Dutchfreak/EspZigbeePlantMonitor/3d Parts/Foot.stl

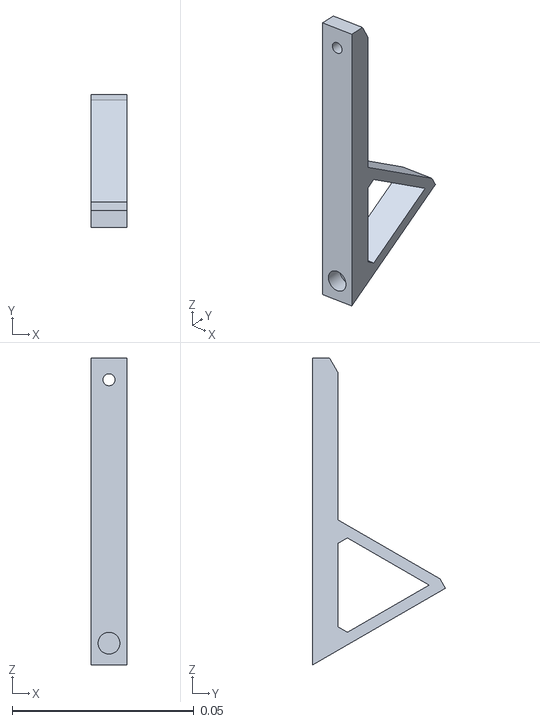
[picture p8: CAD file, 2026-10-31]
3d Parts/Foot.stl
0.01 x 0.0366 x 0.0845
