Dutchfreak/EspZigbeePlantMonitor/3d Parts/Backside.stl

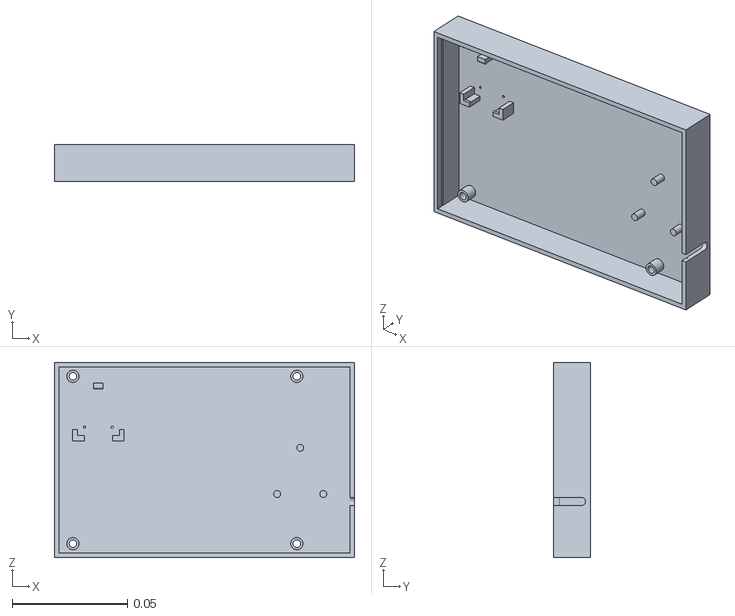
[picture p9: CAD file, 2026-10-31]
3d Parts/Backside.stl
0.13 x 0.016 x 0.0845
