Dutchfreak/EspZigbeePlantMonitor/3d Parts/FrontPlate.stl

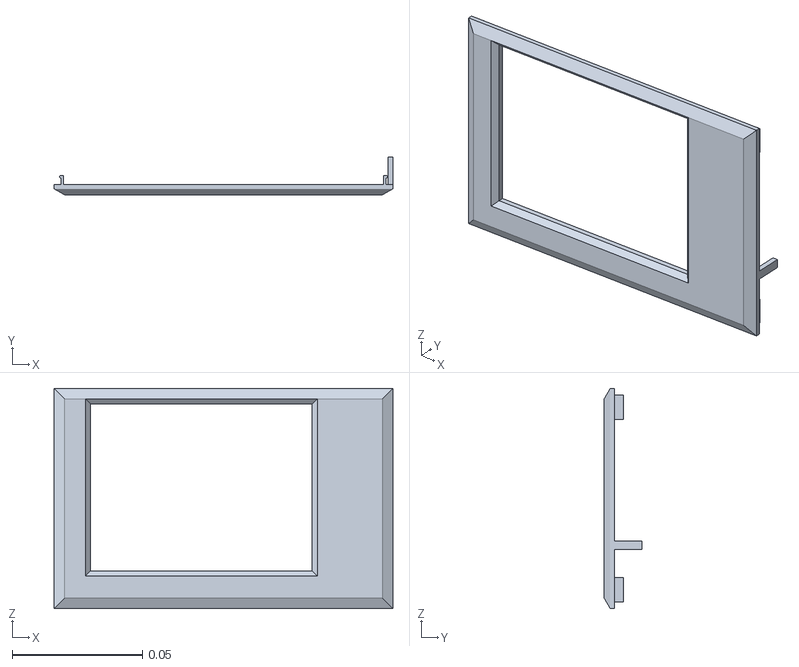
[picture p10: CAD file, 2026-10-31]
3d Parts/FrontPlate.stl
0.13 x 0.0144 x 0.0845
