Dutchfreak/EspZigbeePlantMonitor/(commit log)

2026-10-22 First Commit, Working Zigbee host. Can Scan for devices and add them to the network. Reads all sensor values and sends them to serial. Can Rename devices to readable names.
2026-10-23 Updated The UI to be a bit cleaner. Added Timeout for the sensors. When sensor times out the UI row is inverted. Timeout can be set via serial and is stored.
    [main.cpp]
2026-10-24 Enabled external antenna. Added Removing of devices in list. Added Last seen time for devices in list. Added RSSI for devices in list. Reworked the list to be more user friendly.
    [main.cpp]
2026-10-30 Added a warning icon when moisture drops below 20% Fixed the refresh icon. Fromatted the code.
    [main.cpp, refresh_icons.cpp]
2026-10-31 Added 3d print files. Updated Readme with assembly instructions and pictures.
    [Backside.stl, Foot.stl, FrontPlate.stl]
